inherentlyMalicious/EE3/projectReport/PathFollowerReport.pdf

EE3: Introduction to

Electrical Engineering

- Path Following Robot -

Brian Dionigi Raymond
Kevin Ke-En Sun
Instructor: Prof. Briggs
December 17, 2017

Introduction

The goal of the project was to design a car able to follow a path represented by a black line on a white piece of paper. A PID function will be used to control the steering of the car. In addition, the car must be able to sense the stop at the end of the track and automatically stop. The extra credit portion of this project was to be able to sense, using speed sensors, when the motors have come to a stop and signal to the car that it must momentarily drive the motors at a higher duty cycle to get them moving again.
The car uses three sensors to detect where to go on the path, one on the front, one on the right, and one on the left. The sensors work by using an IR LED that reflects IR light off the ground and into a phototransistor. They are connected to each other as shown in Figure 1a. A phototransistor works like a transistor; a transistor is like a switch. A transistor has three terminals: a base, an emitter, and a collector. When a voltage is applied to the base that is relatively higher than the voltage on the emitter, current is allowed to flow from the emitter to the collector. If the voltage applied to the base is relatively lower than the voltage on the emitter, then no current is allowed to flow. A phototransistor is different from a regular transistor, however, in that the base is sensitive to light as opposed to voltage. When light is shown on the base, current is allowed to flow. If no light is being shown then no current flows. An emitter follower setup was used for the sensors (signal response is low in absence of IR light and high in its presence).

Circuits for Path Sensing and Movement


(a) IR LED and Phototransistor Circuit


(b) Motor and LED Circuit

Figure 1: Circuit schematics for our path following car. In Figure 1a, the 1k resistors attached to the IR LEDs between the Vin and anode (+) as well as 10k resistors attached to the photo transistors between the emitter and ground. The phototransistors go to Analog pins since their data is transmitted as an analog signal ranging from 0 − 1000(arb.). In Figure 1b, the LEDs are wired the same way as the IR LEDs from before. The TIP120 is connected to Vin through a 1k resistor on its base, to the motor through its collector, and to ground through its emitter. All of the circuits were created using Tinkercad[1].

1

The car goes straight whenever the front sensor triggers low. As soon as either the left or right sensors trigger low, the car turns in the opposite direction (left if right triggers, right if left triggers) until the front sensor again triggers low. The rate at which the car turns back towards the front sensor was adjusted using PID methods[2] to allow the car to orient itself along the line both faster and more precisely. After the front sensor triggers low, the car then continues straight again and repeats this process until the stop conditions are met.
A pulse width modulation (PWM) and transistor are used in conjunction to control the speed of the motor. See Figure 1b for the proper wiring. The PWM signal is connected to the base of the transistor and the duty cycle of the PWM is used to control the speed of the motor. Increasing the duty cycle of the PWM increases the speed of the motor by increasing the relative time it is on to that for which it is off. LEDs are used to signal which direction the car is going: a green LED signals forward, a red LED signals left, and a blue LED signals right. In the case of the car’s stopping conditions being met, the car stops moving and then both the blue and red LEDs turn on. LEDs have two sides: a negative (‘n’) side and a positive (‘p’) side. The n side is filled with electrons and the p side is filled with holes. Energy is released when electrons annihilate the holes, with this energy cultivating itself in the form of light.

Testing Methodology

How We Designed the Test

To obtain a comprehensive test of our path sensing subsystem and sensors, we took a multi step approach by testing the initial, adjusted, and mapped readings from our getDistance() function before testing the entire function. Each of our tests involved a setup where the car was propped onto a cardboard jack (e.g. paper roll) and the sensors suspended over a stationary piece of paper that was unmarked besides lines acting as a metric ruler. Using another similarly delineated paper with a

Sensor Testing Rig and Setup


(a) Cardboard Jack


(b) Sliding and Stationary Ruler

Figure 2: Figure 2a shows how the car was suspended above the ruler. Figure 2b shows both rulers; the stationary ruler with a range of ±5cm and the sliding ruler with a range of ±4cm.

2

2cm-wide black line approximating that of the course’s, we aimed to simulate the car’s motion by moving the line to different distances along the sensor axis. With our setup in place, we began recording values from trials at each of the steps.

How We Conducted the Test

The test was conducted in four parts. For the first three parts, which consisted of the function component tests, we took measurements for each of the sensors separately, centering them on the black line, and measured ±1cm from the edge of the line. Originally, we measured ±2cm but noticed that past a centimeter made no difference as the IR phototransistor was unable to read that far away. From these three trials, we were able to tune our processing of the sensor readings to better gauge the distance. Then for the final trial, where we tested the overall getDistance() function, we took measurements by going to the right and left sensors (±4cm) and taking measurements of the estimated distance at 0.25cm intervals going back to the center.

How We Analyzed the Test Data

After each of our trials, we graphed the estimated distance (function’s output printed to Serial) versus the actual distance (as measured). The first trial gave us a polynomial-looking graph so we found the polynomial regression and solved in terms of y in order to obtain a distance value from the sensor reading. Taking new measurements using our newly found formulas gave us the second trial, where after graphing, we noticed our global minima were preserved for each of the sensors but the range condensed. We knew the range was limited as from Trial 1 we found that the sensors could read ±1cm away. Having adjusted our code once more before our final trial, we moved onto the fourth and final trial, where we graphed all of the sensors on the same axis with x=0 being the center of the front sensor. From here we began our interpretation of the results.

How We Interpreted the Data

Looking at the trial of the overall performance of the getDistance() function, performance was interpreted according to two metrics: absolute error at different points and overall trend. For the sensor function to be acceptable, the distance as output by the function should decrease as the black line goes from the left or right sensor towards the front sensor and reach a minimum once at the direct center of the front sensor and car. In addition to this, we judged success on the difference between the estimated distance and the actual distance. As the sensor can only read a maximum of 1cm away, we aimed for a maximum error of half that or 0.5cm.

Results and Discussion

Test Discussion

Looking at the results of our first trial as seen in Figure 3, we were able to fit a polynomial regression to the readings from each sensor fairly well, with a minimum r

2 value of 0.927 and a maximum r

2 value
of 0.989. From there, our first attempt at obtaining the distance from line based on sensor readings was too compressed in range but after mapping looked to approximate each sensor relatively well. This was confirmed by our second and third trials in Figure 4 where by using the polynomial fit we had the correct magnitude but only after mapping did we have the correct range. However, once we ran our final trial and looked at the data our function was clearly lacking in ‘blind zones’ between the front and side sensors (-1.25cm to -2.75cm on the left and 1cm to 3cm on the right). This was to be expected, however, as using only three sensors across such a large range limits the line of sight. Regardless of this, the function performed well for the other values which were within range of a sensor and gave us a maximum error of about 0.5cm. See the section entitled ‘Tables and Graphs’ for the figures referenced in this previous section.

3

Race Day Results

On our test day, our car completed the 20ft course containing four 90 degree turns and five straight sections in 29.7 seconds. Originally it completed the course in 33.4 seconds but with some adjustments we were able to get it going faster on this specific track by adjusting our PID constants and base speed.

Conclusions and Future Work

Our project met the objective of following path fairly well. Despite the fact that it did so in a non-ideal manner by moving along the path sinusoidally, the car never deviated too far away from the path. In addition, we were also able to complete an additional goal of the project which was to detect a stopped wheel by using a photomicrosensor. One thing we learned during the project is the value of being able to read datasheets and using them to create an organized circuit. Keeping the circuit organised not only helps whenever we are trying to figure out wiring issues, but also keeps live wires from touching each other and potentially shorting or otherwise damaging a circuit component. Another thing we learned was how to effectively use a PID function to help with differential steering, and the procedure to test and find the constants for our PID method. Based on how quickly and accurately the car is able to track the center line, we know whether or not the PID constants kp, kd, or ki need to be adjusted.

Given more time, an extension we would like to have done is test different configurations of sensors instead of being limited to using three. By testing other sensor layouts we could have potentially solved the issue of having a ‘blind zone’ that we found during our sensor subsystem tests. This would increase the accuracy of which our car can measure distance as there optimally wouldn’t be an area for which no sensor can obtain a reading. Our PID function would see an improvement from this and could also be better tuned since error calculation would be more responsive and precise.

We would test this improvement by using the same method we tested our three sensor subsystem as it not only allows us to see the accuracy but also tune the function in the process.

References

1. Autodesk, Inc. Tinkercad version 3.6. Dec. 4, 2017. %7Bhttps://www.tinkercad.com/%7D.
2. Beauregard, B. Improving the Beginner’s PID – Introduction 2011.
%7Bhttp://brettbeauregard.com/blog/2011/04/improving-the-beginners-pid-introduction/%7D.

4

Tables and Graphs

Raw Data from Sensors

Sensor Values (arb.)

Distance (cm.) | Left | Front Right
2.00 | 988 | 986 | 982
1.75 | 988 | 986 | 982
1.50 | 988 | 985 | 982
1.25 | 988 | 984 | 981
1.00 | 987 | 983 | 973
0.75 | 876 | 980 | 506
0.50 | 718 | 782 | 443
0.25 | 680 | 544 | 380
0.00 | 656 | 499 | 362
-0.25 | 634 | 501 | 374
-0.50 | 640 | 590 | 381
-0.75 | 786 | 743 | 655
-1.00 | 985 | 980 | 980
-1.25 | 986 | 982 | 982
-1.50 | 987 | 986 | 982
-1.75 | 987 | 986 | 982
-2.00 | 987 | 986 | 982

Table 1: Readings obtained from each of the sensors during Trial 1 by printing to Serial.Out().

5

Adjusted and Mapped Distance from Sensors

Distance, Adjusted (cm.) | Distance, Mapped (cm.)
Distance (cm.) | Left | Front | Right | Left | Front | Right
-1.50 | 0.97 | 0.75 | 1.06 | 1.00 | 0.99 | 1.00
-1.25 | 0.97 | 0.74 | 1.06 | 1.00 | 0.99 | 1.00
-1.00 | 0.97 | 0.74 | 1.05 | 1.00 | 0.99 | 1.00
-0.75 | 0.94 | 0.74 | 0.62 | 0.96 | 0.96 | 0.96
-0.50 | 0.94 | 0.47 | 0.49 | 0.91 | 0.70 | 0.37
-0.25 | 0.94 | 0.42 | 0.47 | 0.65 | 0.08 | 0.19
0.00 | 0.87 | 0.30 | 0.41 | 0.02 | 0.01 | 0.01
0.25 | 0.92 | 0.37 | 0.42 | 0.31 | 0.09 | 0.12
0.50 | 0.94 | 0.50 | 0.67 | 0.48 | 0.29 | 0.37
0.75 | 0.95 | 0.70 | 0.91 | 0.70 | 0.72 | 0.76
1.00 | 0.96 | 0.74 | 1.05 | 0.92 | 0.96 | 0.99
1.25 | 0.97 | 0.75 | 1.06 | 0.99 | 0.98 | 1.00
1.50 | 0.97 | 0.75 | 1.06 | 1.00 | 0.99 | 1.00

Table 2: Readings obtained from Trial 2 and Trial 3 where each sensor was tested individually.

6

Final Trial of Distance Function

Distance (cm.) | Actual (cm.) | Measured (cm.)
-4.00 | 4.00 | 3.88
-3.75 | 3.75 | 3.84
-3.50 | 3.50 | 3.84
-3.25 | 3.25 | 3.70
-3.00 | 3.00 | 3.25
-2.75 | 2.75 | 2.00
-2.50 | 2.50 | 2.00
-2.25 | 2.25 | 2.00
-2.00 | 2.00 | 2.00
-1.75 | 1.75 | 2.00
-1.50 | 1.50 | 2.00
-1.25 | 1.25 | 2.00
-1.00 | 1.00 | 0.96
-0.75 | 0.75 | 0.70
-0.50 | 0.50 | 0.26
-0.25 | 0.25 | 0.12
0.00 | 0.00 | 0.04
0.25 | 0.25 | 0.43
0.50 | 0.50 | 0.97
0.75 | 0.75 | 0.98
1.00 | 1.00 | 2.00
1.25 | 1.25 | 2.00
1.50 | 1.50 | 2.00
1.75 | 1.75 | 2.00
2.00 | 2.00 | 2.00
2.25 | 2.25 | 2.00
2.50 | 2.50 | 2.00
2.75 | 2.75 | 2.00
3.00 | 3.00 | 2.00
3.25 | 3.25 | 3.11
3.50 | 3.50 | 3.24
3.75 | 3.75 | 3.43
4.00 | 4.00 | 3.62

Table 3: Readings from our test of the overall sensor-based line detecting system in the fourth and final Trial.

7

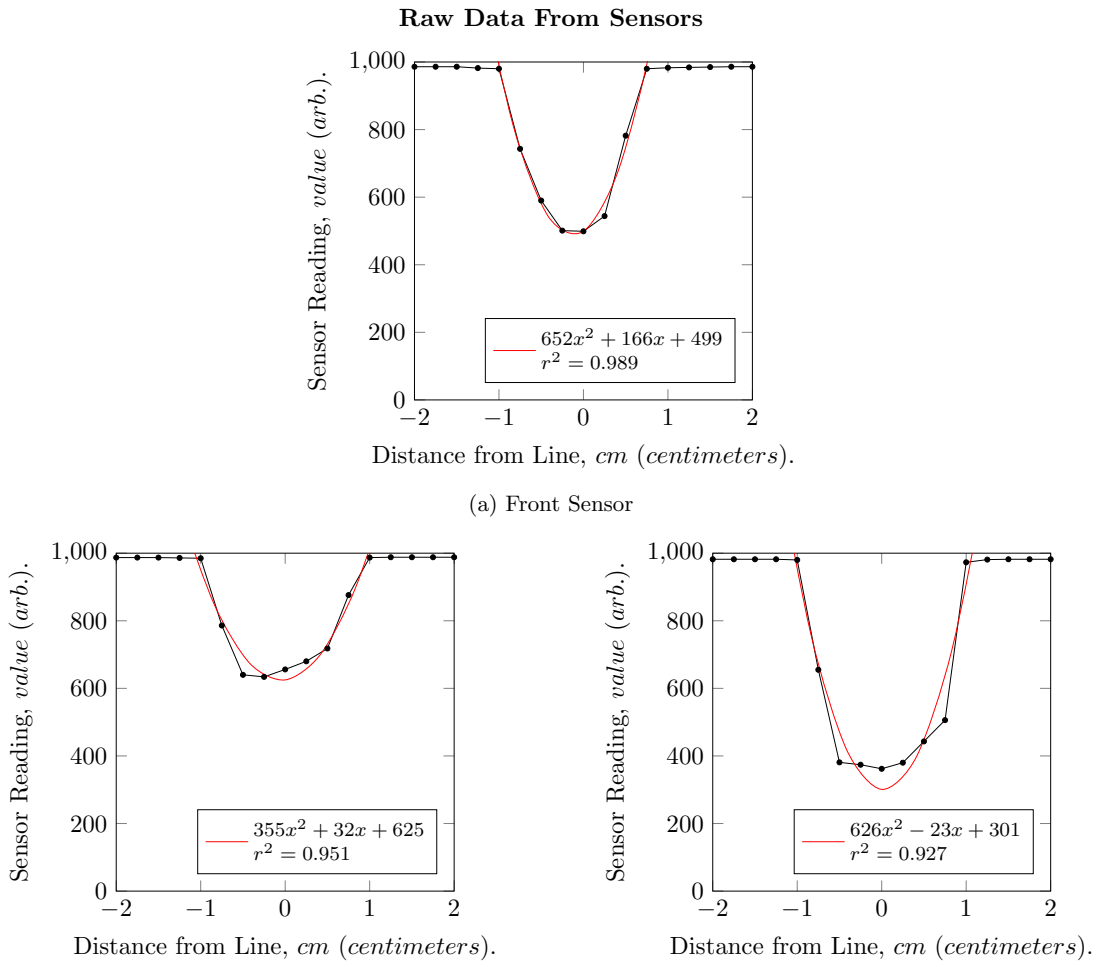
[picture p5: figure]
Raw Data From Sensors; Distance from Line, cm (centimeters).; Sensor Reading, value (arb.).; (a) Front Sensor

(b) Left Sensor
(c) Right Sensor

Figure 3: Raw readings from the IR sensor, IR phototransistor combinations used on our path-following robot. From the graphs, the value of the maximum readings range from about 400 for Graph 4c to about 600 for Graph 4b. Also worth noting is that the sensors each reach trend down to a global minimum of around 0cm when moving from ±1cm to the black line.

8

Adjusted and Mapped Distances From Sensors

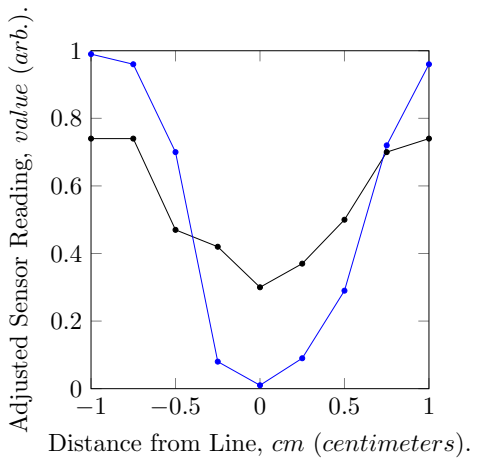
[picture p6: figure]
Distance from Line, cm (centimeters).; Adjusted Sensor Reading, value (arb.).

(a) Front Sensor

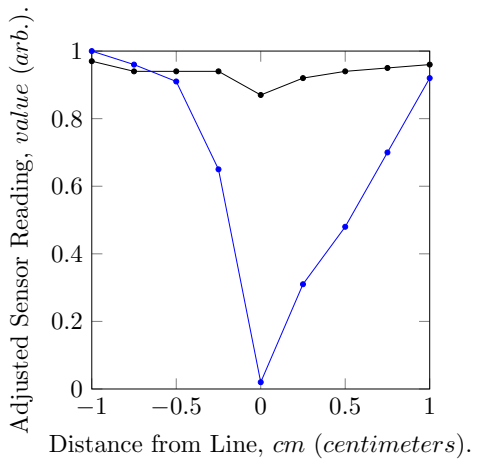
[picture p7: figure]
Distance from Line, cm (centimeters).; Adjusted Sensor Reading, value (arb.).

(b) Left Sensor

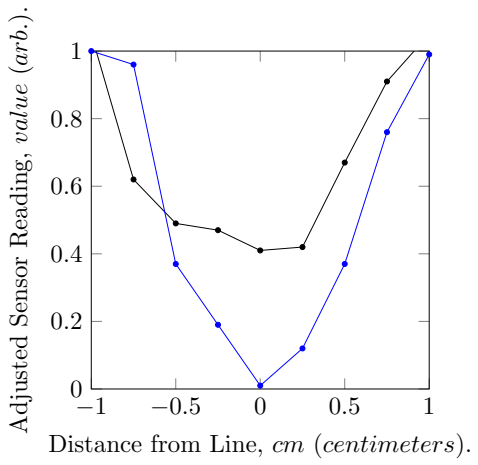
[picture p8: figure]
Distance from Line, cm (centimeters).; Adjusted Sensor Reading, value (arb.).

(c) Right Sensor

Figure 4: Adjusted sensor readings using a crude polynomial fit of the data from Graphs 3a, 3b, and 3c with a degree n = 2 and then mapping to expand the range across the sensors line of sight (0 to 1cm). By using a polynomial fit of the sensor reading (y) versus the distance from the line
(x) and solving in terms y, we are able to both find the distance from our readings and preserve each sensors local minimum at 0cm. From there, we need to adjust the values to fit our known distribution and therefore simply map it as shown. By doing this, we see that our data better fits the distribution and is able to give us more valuable information to use with our PID function as the same change in the sensor reading returns a more significant change (and accurate) change in calculated distance from the line.

9

Absolute Distance From Line, cm (centimeters).

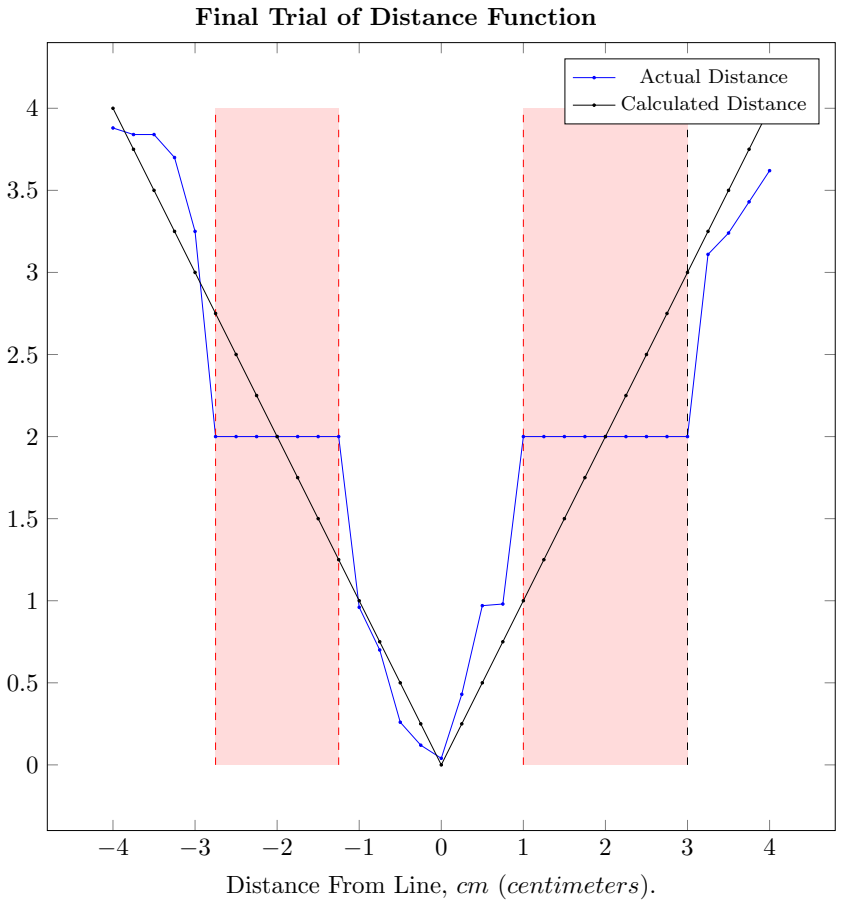
[picture p9: figure]
Final Trial of Distance Function; Distance From Line, cm (centimeters).; Actual Distance; Calculated Distance

Figure 5: Comparison between actual and measured distance (from our getLocation() function) between center of 2cm thin black line and center of robot’s front sensor. The red zone in the figure represent the area for which the black line is not within the range of the left, front, or right sensors. The calculated distance for these areas is just the average value of the actual distance. Looking at this graph, the calculated distance is generally accurate to within less than half a centimeter. Most importantly, the graph slopes to a minimum from both sides, an important feature if a function is to be used for a PID controller.

10
