inherentlyMalicious/EE3/projectReport/sensorsMapped.csv

d | lr | fr | rr | lm | fm | rm
-1.5 | 0.97 | 0.75 | 1.06 | 1 | 0.99 | 1
-1.25 | 0.97 | 0.74 | 1.06 | 1 | 0.99 | 1
-1 | 0.97 | 0.74 | 1.05 | 1 | 0.99 | 1
-0.75 | 0.94 | 0.74 | 0.62 | 0.96 | 0.96 | 0.96
-0.5 | 0.94 | 0.47 | 0.49 | 0.91 | 0.7 | 0.37
-0.25 | 0.94 | 0.42 | 0.47 | 0.65 | 0.08 | 0.19
0 | 0.87 | 0.3 | 0.41 | 0.02 | 0.01 | 0.01
0.25 | 0.92 | 0.37 | 0.42 | 0.31 | 0.09 | 0.12
0.5 | 0.94 | 0.5 | 0.67 | 0.48 | 0.29 | 0.37
0.75 | 0.95 | 0.7 | 0.91 | 0.7 | 0.72 | 0.76
1 | 0.96 | 0.74 | 1.05 | 0.92 | 0.96 | 0.99
1.25 | 0.97 | 0.75 | 1.06 | 0.99 | 0.98 | 1
1.5 | 0.97 | 0.75 | 1.06 | 1 | 0.99 | 1
