inherentlyMalicious/EE3/projectReport/sensorsTest.csv

d | a | m
-4 | 4 | 3.88
-3.75 | 3.75 | 3.84
-3.5 | 3.5 | 3.84
-3.25 | 3.25 | 3.7
-3 | 3 | 3.25
-2.75 | 2.75 | 2
-2.5 | 2.5 | 2
-2.25 | 2.25 | 2
-2 | 2 | 2
-1.75 | 1.75 | 2
-1.5 | 1.5 | 2
-1.25 | 1.25 | 2
-1 | 1 | 0.96
-0.75 | 0.75 | 0.7
-0.5 | 0.5 | 0.26
-0.25 | 0.25 | 0.12
0 | 0 | 0.04
0.25 | 0.25 | 0.43
0.5 | 0.5 | 0.97
0.75 | 0.75 | 0.98
1 | 1 | 2
1.25 | 1.25 | 2
1.5 | 1.5 | 2
1.75 | 1.75 | 2
2 | 2 | 2
2.25 | 2.25 | 2
2.5 | 2.5 | 2
2.75 | 2.75 | 2
3 | 3 | 2
3.25 | 3.25 | 3.11
3.5 | 3.5 | 3.24
3.75 | 3.75 | 3.43
4 | 4 | 3.62
