inherentlyMalicious/EE3/(commit log)

2017-11-15 Basic PID Skeleton
    Still need to verify helper functions and find values for kp,ki,kd
2017-11-27 Distance works
    Doesn't turn right for some reason but the light lights up
    [path_follower.ino]
2017-11-30 Turning works correctly
    Using curState.dir as the 'direction' now
    [path_follower.ino]
2017-12-01 Path Following w/o Tuning
    Follows a path but still need to tune the PID constants
2017-12-03 Stopping Conditions
    Added a stopping condition, change stopDeltaT to modify how soon
    left/right sensors must trigger to stop
2017-12-04 TeX Graphs
    Added the graphs for our 'test'
    [sensorsMapped.csv, sensorsRaw.csv, sensorsTest.csv]
2017-12-06 Stopped Wheel Detection + Report Testing Procedure
    Perhaps working code for the weel and then formatted some more of the
    TeX file
2017-12-07 Clean Wheel Detection
    finalized and cleaned up wheel detection code
2017-12-08 Formatting Progress
    Formatted some more graphs
    [sensorsMapped.csv]
2017-12-08 Final Arduino Code
    Final code, fixed use of same variable for two separate timing tasks
    [path_follower.ino]
2017-12-10 Restructured folders
    Better organized them, e.g. added a test footage folder
    [sensorsMapped.csv, sensorsRaw.csv, sensorsTest.csv]
